akshatk-khurana/Zetaboard/images/neopixels_09_Jun.png

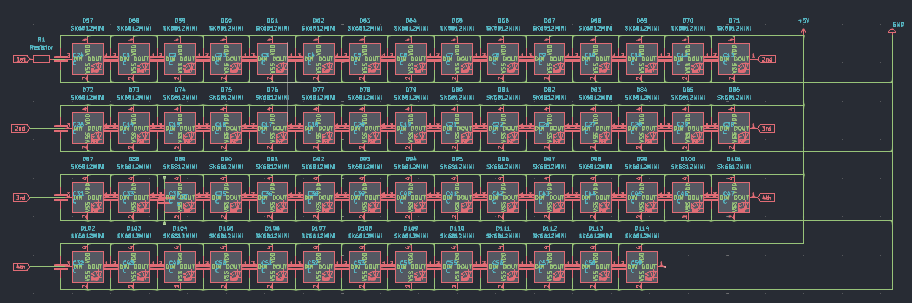
images/neopixels_09_Jun.png
