akshatk-khurana/Zetaboard/images/schematic_complete_08_Jun.png

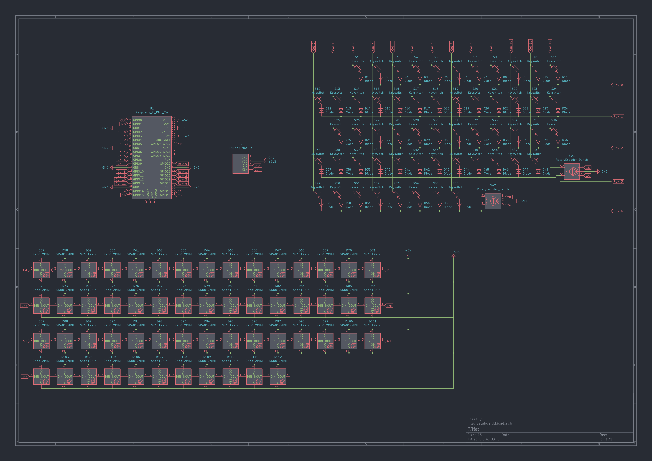
images/schematic_complete_08_Jun.png
