akshatk-khurana/Zetaboard/CAD/Case.step

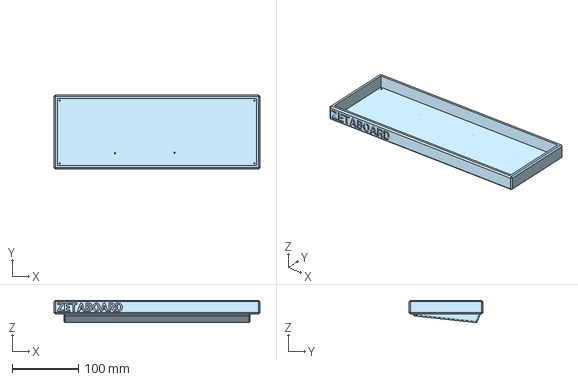
[picture p3: CAD file, 2025-06-18]
CAD/Case.step
312.0 x 112.0 x 33.7 mm
