akshatk-khurana/Zetaboard/CAD/Plate.step

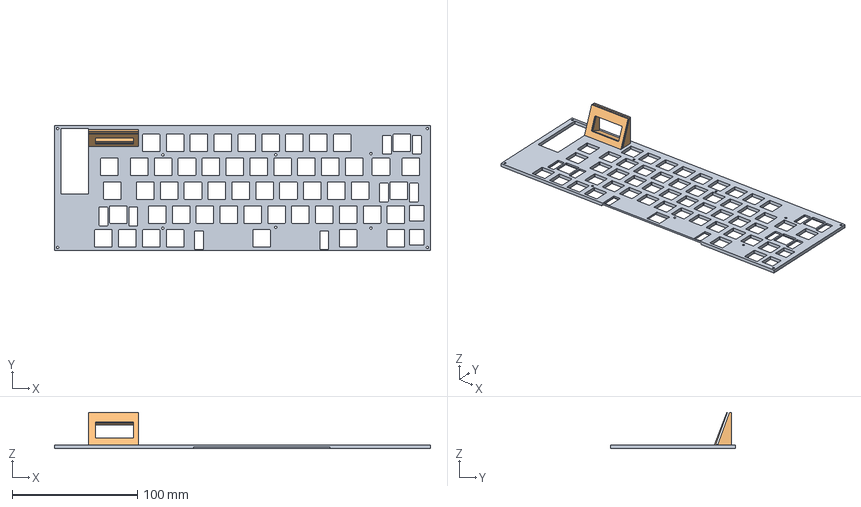
[picture p4: CAD file, 2025-06-18]
CAD/Plate.step
300.0 x 99.9 x 29.1 mm
