akshatk-khurana/Zetaboard/(list of files, cad)

Other CAD files:
plate.dxf
