akshatk-khurana/Zetaboard/PCB/zetaboard/zetaboard.kicad_pcb

## KiCad design PCB/zetaboard/zetaboard.kicad_pcb (2025-06-11)

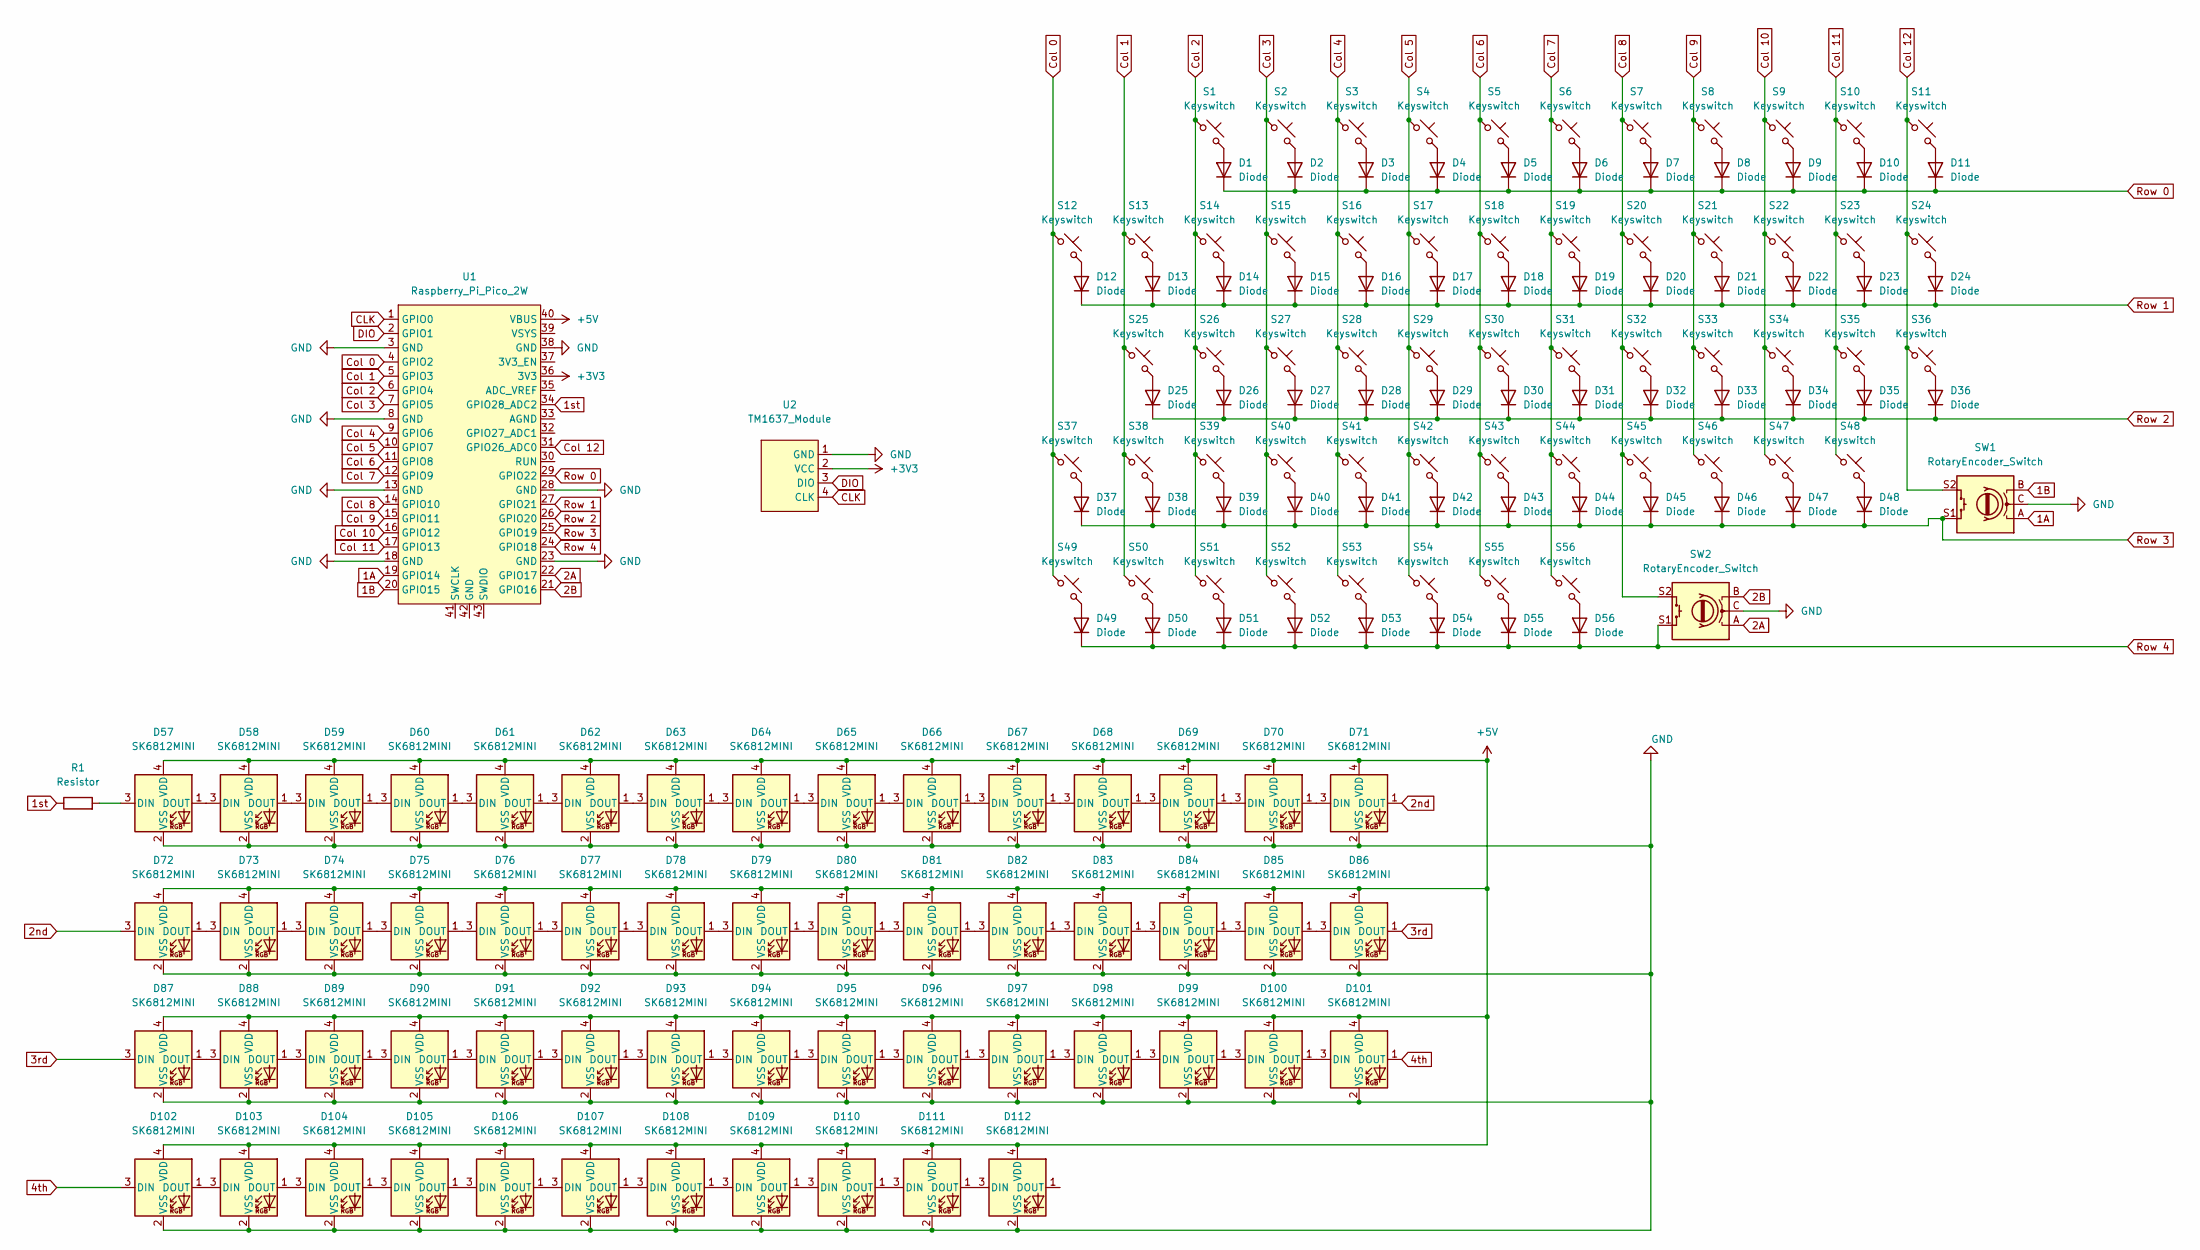
[picture p22: schematic zetaboard.kicad_sch]

Parts:
D1, D2, D3, D4, D5, D6, D7, D8, D9, D10, D11, D12, D13, D14, D15, D16, D17, D18, D19, D20, D21, D22, D23, D24, D25, D26, D27, D28, D29, D30, D31, D32, D33, D34, D35, D36, D37, D38, D39, D40, D41, D42, D43, D44, D45, D46, D47, D48, D49, D50, D51, D52, D53, D54, D55, D56: Diode; Diode_DO-35
D57, D58, D59, D60, D61, D62, D63, D64, D65, D66, D67, D68, D69, D70, D71, D72, D73, D74, D75, D76, D77, D78, D79, D80, D81, D82, D83, D84, D85, D86, D87, D88, D89, D90, D91, D92, D93, D94, D95, D96, D97, D98, D99, D100, D101, D102, D103, D104, D105, D106, D107, D108, D109, D110, D111, D112: SK6812MINI; LED_SK6812MINI_PLCC4_3.5x3.5mm_P1.75mm
R1: Resistor; R_0805_2012Metric
S1, S2, S3, S4, S5, S6, S7, S8, S9, S10, S13, S14, S15, S16, S17, S18, S19, S20, S21, S22, S26, S27, S28, S29, S30, S31, S32, S33, S34, S35, S38, S39, S40, S41, S42, S43, S44, S45, S46, S47, S48, S49, S50, S51, S52, S54, S55, S56: Keyswitch; Hotswap_MX_1.00u
S11: Keyswitch; Hotswap_MX_2.00u
S12: Keyswitch; Hotswap_MX_1.50u
S23, S24: Keyswitch; Hotswap_MX_1.25u
S25: Keyswitch; Hotswap_MX_1.75u
S36, S37: Keyswitch; Hotswap_MX_2.25u
S53: Keyswitch; Hotswap_MX_6.25u
SW1, SW2: RotaryEncoder_Switch; RotaryEncoder_Alps_EC11E-Switch_Vertical_H20mm
U1: Raspberry_Pi_Pico_2W; Raspberry_Pi_Pico
U2: TM1637_Module; TM1637 Display Module

Connections:
1A: SW1.A, U1.19 (GPIO14)
1B: SW1.B, U1.20 (GPIO15)
1st: R1.1, U1.34 (GPIO28_ADC2)
2A: SW2.A, U1.22 (GPIO17)
2B: SW2.B, U1.21 (GPIO16)
2nd: D71.1 (DOUT), D72.3 (DIN)
3rd: D86.1 (DOUT), D87.3 (DIN)
4th: D101.1 (DOUT), D102.3 (DIN)
+3V3: U1.36 (3V3), U2.2 (VCC)
+5V: D57.4 (VDD), D58.4 (VDD), D59.4 (VDD), D60.4 (VDD), D61.4 (VDD), D62.4 (VDD), D63.4 (VDD), D64.4 (VDD), D65.4 (VDD), D66.4 (VDD), D67.4 (VDD), D68.4 (VDD), D69.4 (VDD), D70.4 (VDD), D71.4 (VDD), D72.4 (VDD), D73.4 (VDD), D74.4 (VDD), D75.4 (VDD), D76.4 (VDD), D77.4 (VDD), D78.4 (VDD), D79.4 (VDD), D80.4 (VDD), D81.4 (VDD), D82.4 (VDD), D83.4 (VDD), D84.4 (VDD), D85.4 (VDD), D86.4 (VDD), D87.4 (VDD), D88.4 (VDD), D89.4 (VDD), D90.4 (VDD), D91.4 (VDD), D92.4 (VDD), D93.4 (VDD), D94.4 (VDD), D95.4 (VDD), D96.4 (VDD), D97.4 (VDD), D98.4 (VDD), D99.4 (VDD), D100.4 (VDD), D101.4 (VDD), D102.4 (VDD), D103.4 (VDD), D104.4 (VDD), D105.4 (VDD), D106.4 (VDD), D107.4 (VDD), D108.4 (VDD), D109.4 (VDD), D110.4 (VDD), D111.4 (VDD), D112.4 (VDD), U1.40 (VBUS)
CLK: U1.1 (GPIO0), U2.4 (CLK)
Col 0: S12.1, S37.1, S49.1, U1.4 (GPIO2)
Col 1: S13.1, S25.1, S38.1, S50.1, U1.5 (GPIO3)
Col 2: S1.1, S14.1, S26.1, S39.1, S51.1, U1.6 (GPIO4)
Col 3: S2.1, S15.1, S27.1, S40.1, S52.1, U1.7 (GPIO5)
Col 4: S3.1, S16.1, S28.1, S41.1, S53.1, U1.9 (GPIO6)
Col 5: S4.1, S17.1, S29.1, S42.1, S54.1, U1.10 (GPIO7)
Col 6: S5.1, S18.1, S30.1, S43.1, S55.1, U1.11 (GPIO8)
Col 7: S6.1, S19.1, S31.1, S44.1, S56.1, U1.12 (GPIO9)
Col 8: S7.1, S20.1, S32.1, S45.1, SW2.S2, U1.14 (GPIO10)
Col 9: S8.1, S21.1, S33.1, S46.1, U1.15 (GPIO11)
Col 10: S9.1, S22.1, S34.1, S47.1, U1.16 (GPIO12)
Col 11: S10.1, S23.1, S35.1, S48.1, U1.17 (GPIO13)
Col 12: S11.1, S24.1, S36.1, SW1.S2, U1.31 (GPIO26_ADC0)
DIO: U1.2 (GPIO1), U2.3 (DIO)
GND: D57.2 (VSS), D58.2 (VSS), D59.2 (VSS), D60.2 (VSS), D61.2 (VSS), D62.2 (VSS), D63.2 (VSS), D64.2 (VSS), D65.2 (VSS), D66.2 (VSS), D67.2 (VSS), D68.2 (VSS), D69.2 (VSS), D70.2 (VSS), D71.2 (VSS), D72.2 (VSS), D73.2 (VSS), D74.2 (VSS), D75.2 (VSS), D76.2 (VSS), D77.2 (VSS), D78.2 (VSS), D79.2 (VSS), D80.2 (VSS), D81.2 (VSS), D82.2 (VSS), D83.2 (VSS), D84.2 (VSS), D85.2 (VSS), D86.2 (VSS), D87.2 (VSS), D88.2 (VSS), D89.2 (VSS), D90.2 (VSS), D91.2 (VSS), D92.2 (VSS), D93.2 (VSS), D94.2 (VSS), D95.2 (VSS), D96.2 (VSS), D97.2 (VSS), D98.2 (VSS), D99.2 (VSS), D100.2 (VSS), D101.2 (VSS), D102.2 (VSS), D103.2 (VSS), D104.2 (VSS), D105.2 (VSS), D106.2 (VSS), D107.2 (VSS), D108.2 (VSS), D109.2 (VSS), D110.2 (VSS), D111.2 (VSS), D112.2 (VSS), SW1.C, SW2.C, U1.3 (GND), U1.8 (GND), U1.13 (GND), U1.18 (GND), U1.23 (GND), U1.28 (GND), U1.38 (GND), U2.1 (GND)
unnamed: D1.2 (A), S1.2
unnamed: D2.2 (A), S2.2
unnamed: D3.2 (A), S3.2
unnamed: D4.2 (A), S4.2
unnamed: D5.2 (A), S5.2
unnamed: D6.2 (A), S6.2
unnamed: D7.2 (A), S7.2
unnamed: D8.2 (A), S8.2
unnamed: D9.2 (A), S9.2
unnamed: D10.2 (A), S10.2
unnamed: D11.2 (A), S11.2
unnamed: D12.2 (A), S12.2
unnamed: D13.2 (A), S13.2
unnamed: D14.2 (A), S14.2
unnamed: D15.2 (A), S15.2
unnamed: D16.2 (A), S16.2
unnamed: D17.2 (A), S17.2
unnamed: D18.2 (A), S18.2
unnamed: D19.2 (A), S19.2
unnamed: D20.2 (A), S20.2
unnamed: D21.2 (A), S21.2
unnamed: D22.2 (A), S22.2
unnamed: D23.2 (A), S23.2
unnamed: D24.2 (A), S24.2
unnamed: D25.2 (A), S25.2
unnamed: D26.2 (A), S26.2
unnamed: D27.2 (A), S27.2
unnamed: D28.2 (A), S28.2
unnamed: D29.2 (A), S29.2
unnamed: D30.2 (A), S30.2
unnamed: D31.2 (A), S31.2
unnamed: D32.2 (A), S32.2
unnamed: D33.2 (A), S33.2
unnamed: D34.2 (A), S34.2
unnamed: D35.2 (A), S35.2
unnamed: D36.2 (A), S36.2
unnamed: D37.2 (A), S37.2
unnamed: D38.2 (A), S38.2
unnamed: D39.2 (A), S39.2
unnamed: D40.2 (A), S40.2
unnamed: D41.2 (A), S41.2
unnamed: D42.2 (A), S42.2
unnamed: D43.2 (A), S43.2
unnamed: D44.2 (A), S44.2
unnamed: D45.2 (A), S45.2
unnamed: D46.2 (A), S46.2
unnamed: D47.2 (A), S47.2
unnamed: D48.2 (A), S48.2
unnamed: D49.2 (A), S49.2
unnamed: D50.2 (A), S50.2
unnamed: D51.2 (A), S51.2
unnamed: D52.2 (A), S52.2
unnamed: D53.2 (A), S53.2
unnamed: D54.2 (A), S54.2
unnamed: D55.2 (A), S55.2
unnamed: D56.2 (A), S56.2
unnamed: D57.3 (DIN), R1.2
unnamed: D57.1 (DOUT), D58.3 (DIN)
unnamed: D58.1 (DOUT), D59.3 (DIN)
unnamed: D59.1 (DOUT), D60.3 (DIN)
unnamed: D60.1 (DOUT), D61.3 (DIN)
unnamed: D61.1 (DOUT), D62.3 (DIN)
unnamed: D62.1 (DOUT), D63.3 (DIN)
unnamed: D63.1 (DOUT), D64.3 (DIN)
unnamed: D64.1 (DOUT), D65.3 (DIN)
unnamed: D65.1 (DOUT), D66.3 (DIN)
unnamed: D66.1 (DOUT), D67.3 (DIN)
unnamed: D67.1 (DOUT), D68.3 (DIN)
unnamed: D68.1 (DOUT), D69.3 (DIN)
unnamed: D69.1 (DOUT), D70.3 (DIN)
unnamed: D70.1 (DOUT), D71.3 (DIN)
unnamed: D72.1 (DOUT), D73.3 (DIN)
unnamed: D73.1 (DOUT), D74.3 (DIN)
unnamed: D74.1 (DOUT), D75.3 (DIN)
unnamed: D75.1 (DOUT), D76.3 (DIN)
unnamed: D76.1 (DOUT), D77.3 (DIN)
unnamed: D77.1 (DOUT), D78.3 (DIN)
unnamed: D78.1 (DOUT), D79.3 (DIN)
unnamed: D79.1 (DOUT), D80.3 (DIN)
unnamed: D80.1 (DOUT), D81.3 (DIN)
unnamed: D81.1 (DOUT), D82.3 (DIN)
unnamed: D82.1 (DOUT), D83.3 (DIN)
unnamed: D83.1 (DOUT), D84.3 (DIN)
unnamed: D84.1 (DOUT), D85.3 (DIN)
unnamed: D85.1 (DOUT), D86.3 (DIN)
unnamed: D87.1 (DOUT), D88.3 (DIN)
unnamed: D88.1 (DOUT), D89.3 (DIN)
unnamed: D89.1 (DOUT), D90.3 (DIN)
unnamed: D90.1 (DOUT), D91.3 (DIN)
unnamed: D91.1 (DOUT), D92.3 (DIN)
unnamed: D92.1 (DOUT), D93.3 (DIN)
unnamed: D93.1 (DOUT), D94.3 (DIN)
unnamed: D94.1 (DOUT), D95.3 (DIN)
unnamed: D95.1 (DOUT), D96.3 (DIN)
unnamed: D96.1 (DOUT), D97.3 (DIN)
unnamed: D97.1 (DOUT), D98.3 (DIN)
unnamed: D98.1 (DOUT), D99.3 (DIN)
unnamed: D99.1 (DOUT), D100.3 (DIN)
unnamed: D100.1 (DOUT), D101.3 (DIN)
unnamed: D102.1 (DOUT), D103.3 (DIN)
unnamed: D103.1 (DOUT), D104.3 (DIN)
unnamed: D104.1 (DOUT), D105.3 (DIN)
unnamed: D105.1 (DOUT), D106.3 (DIN)
unnamed: D106.1 (DOUT), D107.3 (DIN)
unnamed: D107.1 (DOUT), D108.3 (DIN)
unnamed: D108.1 (DOUT), D109.3 (DIN)
unnamed: D109.1 (DOUT), D110.3 (DIN)
unnamed: D110.1 (DOUT), D111.3 (DIN)
unnamed: D111.1 (DOUT), D112.3 (DIN)
Row 0: D1.1 (K), D2.1 (K), D3.1 (K), D4.1 (K), D5.1 (K), D6.1 (K), D7.1 (K), D8.1 (K), D9.1 (K), D10.1 (K), D11.1 (K), U1.29 (GPIO22)
Row 1: D12.1 (K), D13.1 (K), D14.1 (K), D15.1 (K), D16.1 (K), D17.1 (K), D18.1 (K), D19.1 (K), D20.1 (K), D21.1 (K), D22.1 (K), D23.1 (K), D24.1 (K), U1.27 (GPIO21)
Row 2: D25.1 (K), D26.1 (K), D27.1 (K), D28.1 (K), D29.1 (K), D30.1 (K), D31.1 (K), D32.1 (K), D33.1 (K), D34.1 (K), D35.1 (K), D36.1 (K), U1.26 (GPIO20)
Row 3: D37.1 (K), D38.1 (K), D39.1 (K), D40.1 (K), D41.1 (K), D42.1 (K), D43.1 (K), D44.1 (K), D45.1 (K), D46.1 (K), D47.1 (K), D48.1 (K), SW1.S1, U1.25 (GPIO19)
Row 4: D49.1 (K), D50.1 (K), D51.1 (K), D52.1 (K), D53.1 (K), D54.1 (K), D55.1 (K), D56.1 (K), SW2.S1, U1.24 (GPIO18)

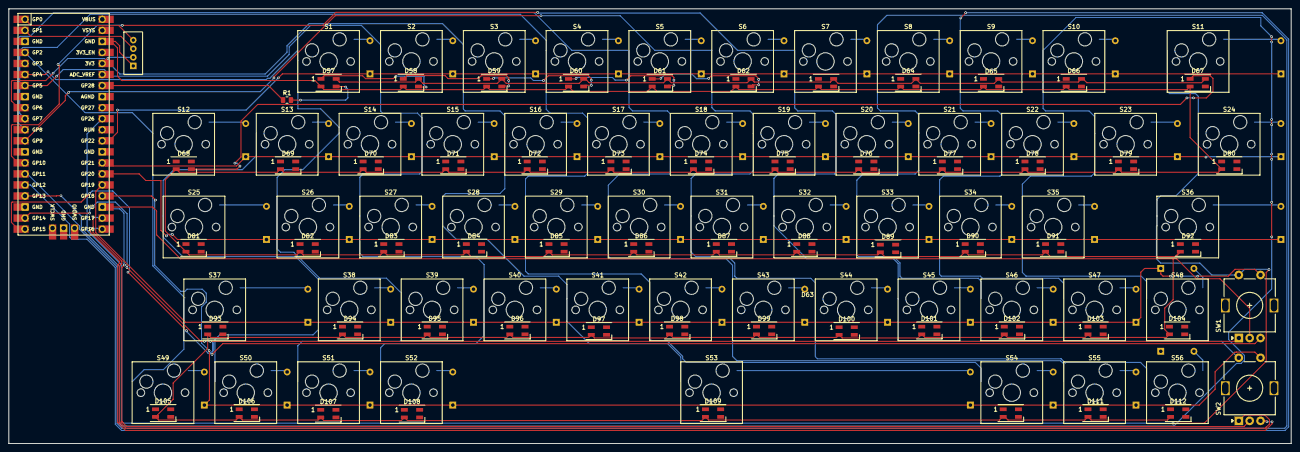
[picture p23: board zetaboard.kicad_pcb from above]

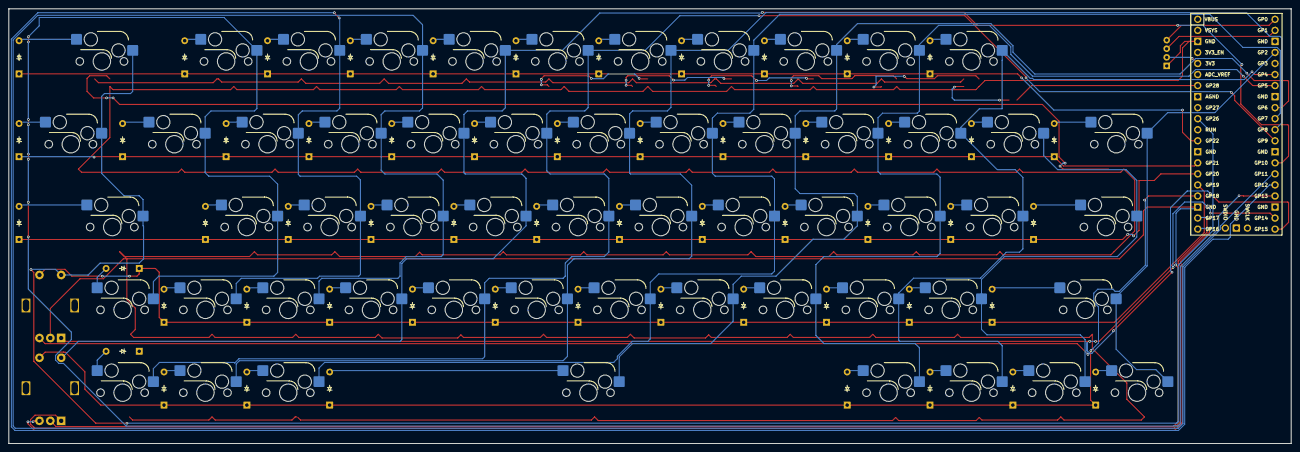
[picture p24: board zetaboard.kicad_pcb from below]

Board: 2 copper layers, 295.0 x 100.0 mm, 173 parts (56 on the bottom side), 140 nets.
