akshatk-khurana/Zetaboard/(commit log)

2025-06-07 Almost finished BOM
2025-06-07 Changed .gitignore
    [BOM.csv]
2025-06-09 Starting the schematic
    [BOM.csv, zetaboard.kicad_pcb, zetaboard.kicad_sch]
2025-06-10 Schematic finished and PCB started.
    [zetaboard.kicad_pcb, zetaboard.kicad_sch]
2025-06-11 Save commit just in case I mess something up with removing the capacitors
    [zetaboard.kicad_pcb, zetaboard.kicad_sch]
2025-06-11 Still on the PCB
    [zetaboard.kicad_pcb, zetaboard.kicad_sch]
2025-06-15 (Basically) finished PCB and started work on plate
    [bom.csv, designators.csv, plate.dxf, positions.csv, zetaboard.kicad_sch]
2025-06-18 Finally finished the case! Onto firmware now...
    [Case.step, Plate.step]
